MYLMMMM/car2025/README.md

# car2025
本项目是开发用于参赛的缩微电磁赛道智能车
参赛队伍：没电电磁队
