MYLMMMM/car2025/控制板/新建 文本文档.md

# 缩微电磁控制板使用说明

## 功能列表

### 板载部分

- 1.按钮，编码器
- 2.电源电压检测
- 3.电机驱动
- 4.电机电流检测
- 5.*起始点检测霍尔传感器*

### 接口

- 1.电机编码器
- 2.电磁传感器
- 3.电机
- 4.IMU
- 5.OLED
- 6.usb下载调试
- 7.蓝牙串口

## 详细说明

### 板载部分

#### 1.按钮、编码器

##### 引脚定义
| 名称 | 引脚 | 外设 |备注|
|---|---|---|---|
|PIN1|P2.1|GPIO|编码器按钮|
|PIN2|P2.0|GPIO| |
|PIN3|P4.0|GPIO| |
|PIN4|P5.7|GPIO| |
|RES|P4.7|GPIO| |
|ENC_A|P4.1|PWM定时器|寄存器配置，文档P887页|
|ENC_B|P4.5|GPIO|仅用于判断方向|

#### 2.电源电压检测
##### 引脚定义

| 名称 | 引脚 | 外设 |备注|
|---|---|---|---|
|VCC_ADC|P1.0|ADC||

##### 计算公式
电源电压 = ADC读取值*9

#### 3.电机驱动

##### 引脚定义

*待施工*

#### 4.电机电流检测

##### 引脚定义

*待施工*

### 接口部分

#### 1.电机编码器

##### 引脚定义
