MYLMMMM/car2025/控制板/BOM_主板第三版_PCB9_1_2025-06-06.xlsx

Quantity | Designator | Footprint | Value | Device | No.
1 | BUZ1 | BUZ-SMD_3P-L5.5-W5.0_5025 |  | 5025贴片蜂鸣器 | 1
1 | C1 | C0603 | 0.1uF | CAP_0402 | 2
3 | C2,C8,C9 | C0603 | 4.7uF | CAP_0402 | 3
1 | C4 | C0603 | 4.7nF | CAP_0402 | 4
1 | C5 | C0603 | 39pF | CAP_0402 | 5
1 | C10 | C0603 | 10pF | CAP_0402 | 6
16 | C13,C15,C16,C17,C18,C19,C30,C34,C35,C36,C37,C38,C39,C40,C41,C42 | C0603 | 100nF | CAP_0402,CAP_0603 | 7
4 | C20,C21,C31,C32 | C0603 | 1uF | CAP_0402 | 8
2 | C22,C23 | C0603 | 33uF | CAP_0603 | 9
1 | CN5 | CONN-TH_4P-P2.50_4PIN |  | ZX-XH2.54-4PZZ | 10
2 | CN8,CN9 | IDC-TH_6P-P2.54-H-R2-C3-S2.54 |  | 2.54-2*3P弯简牛 | 11
1 | CN10 | CONN-TH_3P-P2.54_2501S-3P |  | ZX-XH2.54-3PZZ | 12
1 | CN11 | HDR-TH_4P-P2.54-V-F |  | JTAG | 13
1 | CN12 | CONN-TH_XT30U-M |  | XT30U-M | 14
2 | CN13,CN14 | CONN-TH_2P-P2.50_HX25003-2A |  | ZX-XH2.54-2PZZ | 15
1 | D1 | SMA_L4.3-W2.6-LS5.1-RD |  | B340A | 16
2 | D3,D4 | SMA_L4.3-W2.6-LS5.2-RD |  | SS34_C8678 | 17
1 | D5 | SMA_L4.4-W2.6-LS5.0-RD |  | SMAJ5.0A | 18
3 | D6,D7,D8 | SMA_L4.3-W2.7-LS5.1-RD |  | SMAJ3.3A | 19
1 | H1 | HDR-TH_8P-P2.54-V-M |  | PZ254-1-08-Z-8.5 | 20
1 | H3 | HDR-TH_07P-P2.54-V-M |  | PZ254-1-07-Z-8.5 | 21
1 | H9 | HDR-TH_5P-P2.54-V-M |  | PZ254-1-05-Z-8.5 | 22
1 | L1 | IND-SMD_L4.9-W4.4_MAPM0420F | 4.7uH | HA42-4R7MT | 23
2 | LDO2,LDO3 | SOT-23-5_L3.0-W1.7-P0.95-LS2.8-BL |  | ME6211C33M5G-N | 24
4 | LED4,LED5,LED6,LED7 | LED_0603 |  | LED_0603-R | 25
2 | P1,P2 | HDR-TH_1P-P2.54-V-M |  | 2.54-1*1P针 | 26
7 | Q2,Q3,Q4,Q5,Q6,Q7,Q8 | SOT-23-3_L2.9-W1.3-P1.90-LS2.4-BR |  | AO3400A_C20917,MMBT3904(RANGE:100-300),MMBT3906_C18195368 | 27
17 | R1,R10,R11,R12,R13,R14,R15,R16,R17,R18,R19,R28,R29,R32,R33,R35,R40 | R0603 | 10K | Res_0402,Res_0603 | 28
1 | R2 | R0603 | 1.91K | Res_0402 | 29
1 | R3 | R0603 | 49.9k | Res_0402 | 30
2 | R4,R5 | R0603 | 5.1k | Res_0402 | 31
1 | R23 | R0603 | 8K | Res_0603 | 32
1 | R24 | R0603 | 1K | Res_0603 | 33
2 | R25,R26 | R0603 | 22 | Res_0603 | 34
1 | R27 | R0603 | 300R | Res_0603 | 35
2 | R30,R31 | R0603 | 3.3k | Res_0603 | 36
1 | R34 | R0603 | 10 | Res_0603 | 37
2 | R36,R37 | R0603 | 0k | Res_0603 | 38
2 | R38,R39 | R0603 | 50 | Res_0603 | 39
1 | SW1 | SW-TH_EC11K0925416 |  | EC11K0925416 | 40
1 | SW3 | SW-TH_2P-L4.1-W9.6-P2.54-LS7.62 |  | TA-01 | 41
1 | U1 | LQFP-48_L7.0-W7.0-P0.50-LS9.0-BL_1 |  | AI8051U-34K64-QFP48 | 42
2 | U2,U12 | SOIC-8_L4.9-W3.9-P1.27-LS6.0-BL |  | TLV9002IDR,TPS54331DG4 | 43
3 | U4,U5,U7 | SW-TH_4P-L6.0-W6.0-P4.50-LS6.5 |  | TC-6610 6*6*5 160g | 44
1 | U13 | CONN-TH_7P-P1.25_XUNPU_WAFER-MX1.25-7PZZ |  | WAFER-MX1.25-7PZZ | 45
2 | U14,U15 | SOT-23-5_L2.9-W1.6-P0.95-LS2.8-BR |  | INA180B1IDBVR | 46
1 | USB1 | USB-C-SMD_TYPE-C16PIN |  | TYPE-C16PIN | 47
