MYLMMMM/car2025/3d设计文件/3d打印文件/传感器固定架子20度加长.SLDPRT

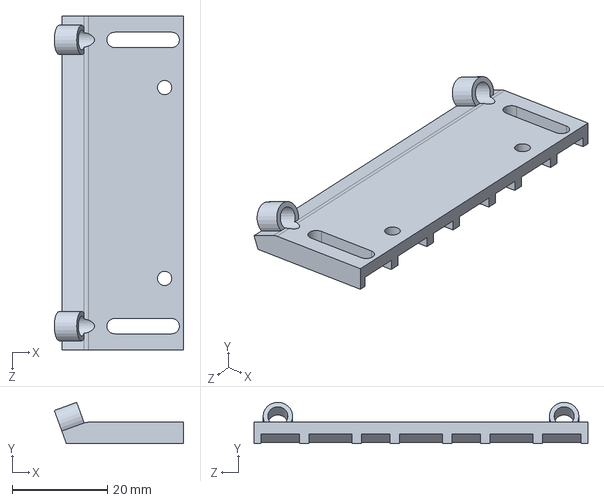
[picture p1: CAD file, 2025-07-23]
3d设计文件/3d打印文件/传感器固定架子20度加长.SLDPRT
27.1 x 8.67 x 70.0 mm
