MYLMMMM/car2025/3d设计文件/3d打印文件/新建文件夹/后保险杠.3MF

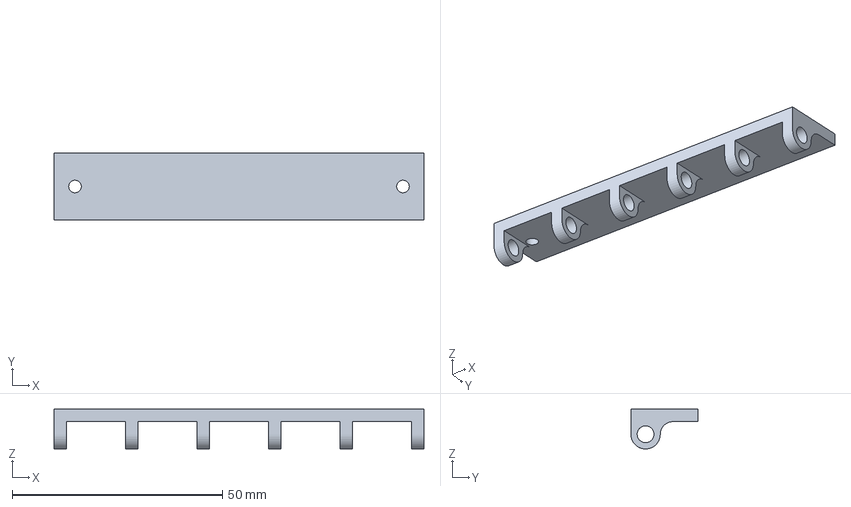
[picture p2: CAD file, 2025-07-23]
3d设计文件/3d打印文件/新建文件夹/后保险杠.3MF
88.0 x 16.0 x 9.50 mm
