MYLMMMM/car2025/3d设计文件/new车模文件/180电机.SLDPRT

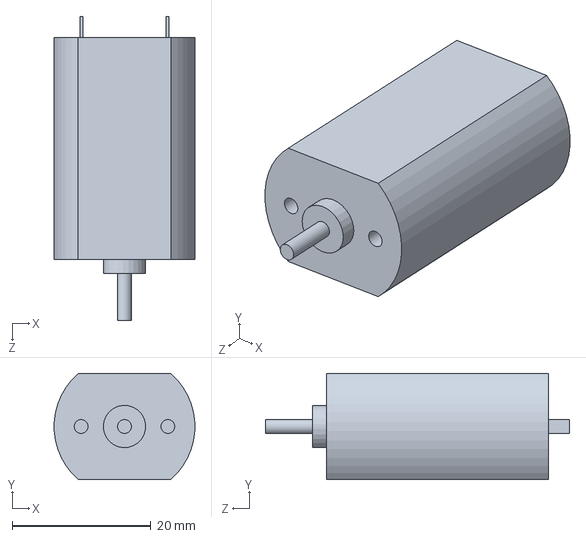
[picture p3: CAD file, 2025-07-23]
3d设计文件/new车模文件/180电机.SLDPRT
20.3 x 15.3 x 43.8 mm
