MYLMMMM/car2025/3d设计文件/测试3d文件/尺寸测试.SLDPRT

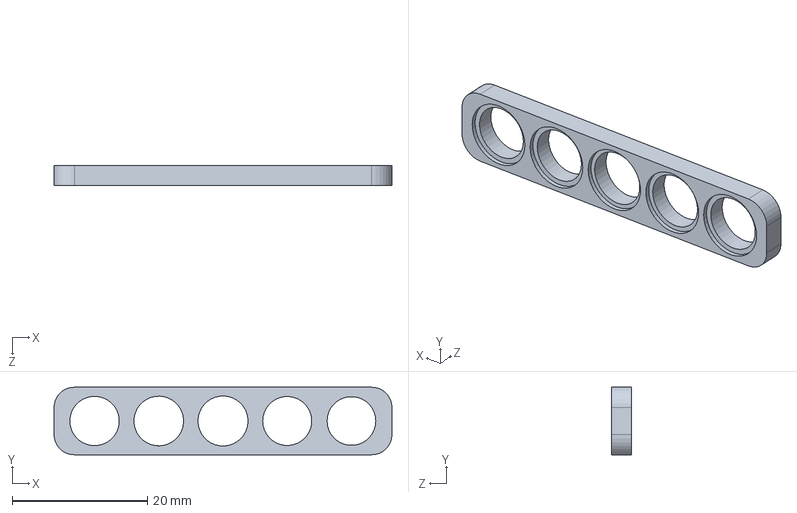
[picture p4: CAD file, 2025-06-23]
3d设计文件/测试3d文件/尺寸测试.SLDPRT
50.0 x 10.0 x 3.00 mm
