MYLMMMM/car2025/3d设计文件/车模3D文件/挡板基体-v2.0.SLDPRT

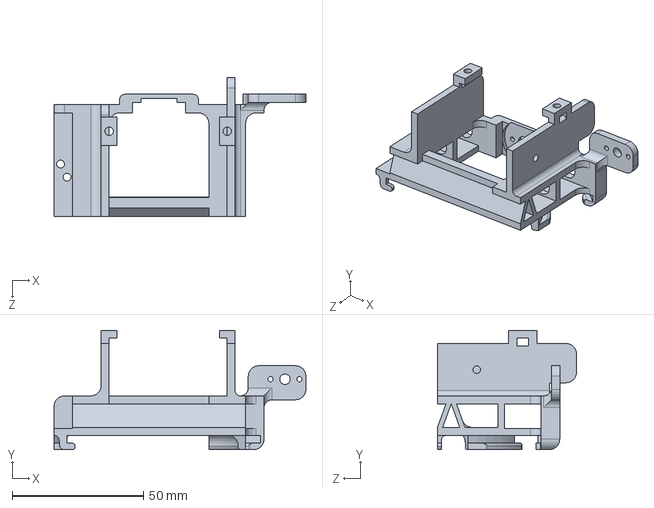
[picture p5: CAD file, 2025-06-23]
3d设计文件/车模3D文件/挡板基体-v2.0.SLDPRT
96.0 x 45.5 x 53.0 mm
