MYLMMMM/car2025/3d设计文件/3d打印文件/新建文件夹/线圈托片.3MF

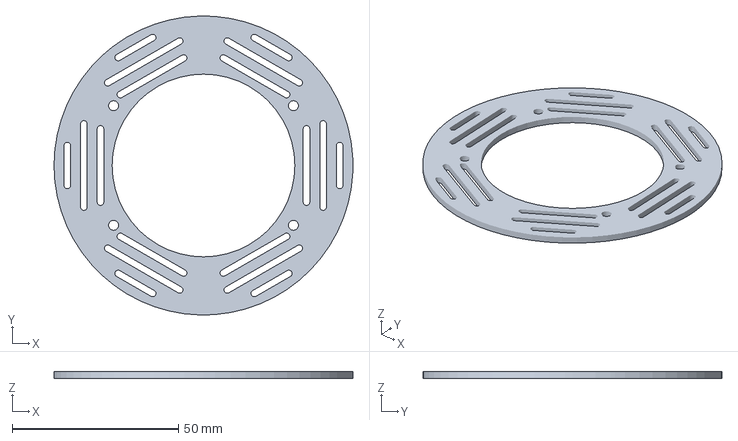
[picture p6: CAD file, 2025-07-23]
3d设计文件/3d打印文件/新建文件夹/线圈托片.3MF
90.0 x 90.0 x 2.00 mm
