MYLMMMM/car2025/3d设计文件/车模3D文件/轮胎.SLDPRT

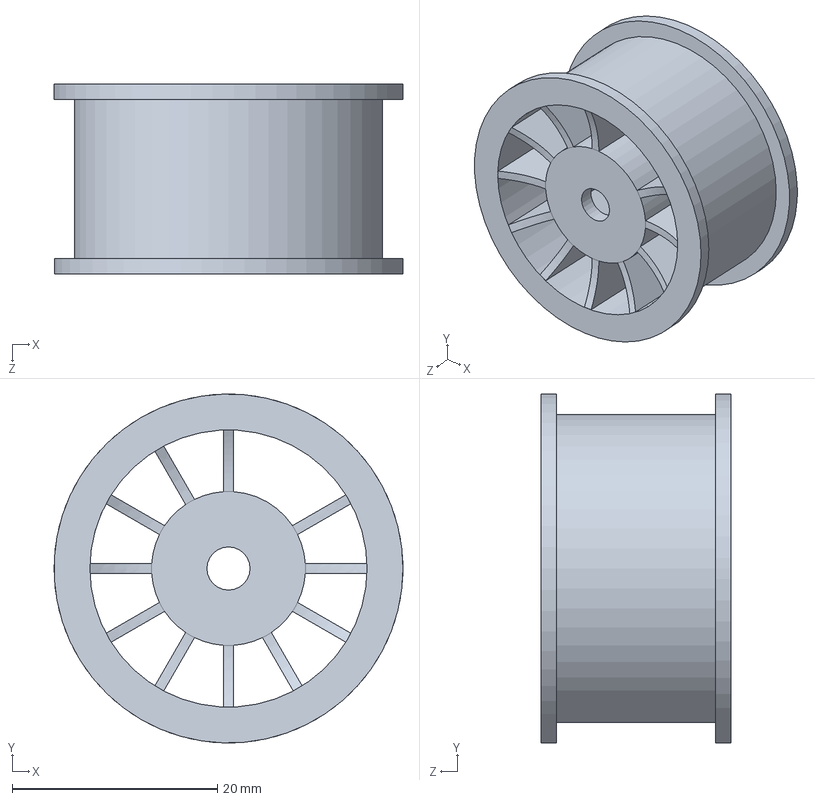
[picture p7: CAD file, 2025-06-23]
3d设计文件/车模3D文件/轮胎.SLDPRT
34.0 x 34.0 x 18.5 mm
