MYLMMMM/car2025/3d设计文件/3d打印文件/前保险杠30度.3MF

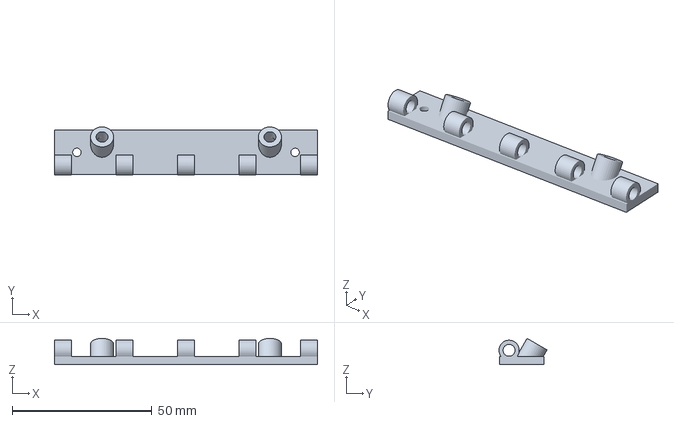
[picture p8: CAD file, 2025-07-23]
3d设计文件/3d打印文件/前保险杠30度.3MF
94.0 x 17.2 x 9.40 mm
