MYLMMMM/car2025/3d设计文件/3d打印文件/新建文件夹/侧板另一边.3MF

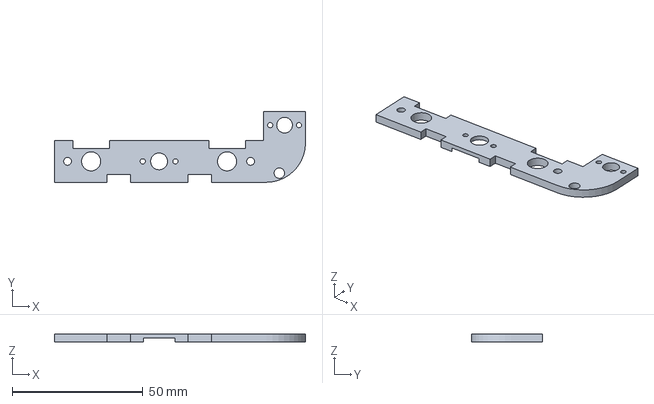
[picture p9: CAD file, 2025-07-23]
3d设计文件/3d打印文件/新建文件夹/侧板另一边.3MF
96.0 x 27.0 x 3.00 mm
