MYLMMMM/car2025/3d设计文件/参考文件/四轮完整版 - 车板.3mf

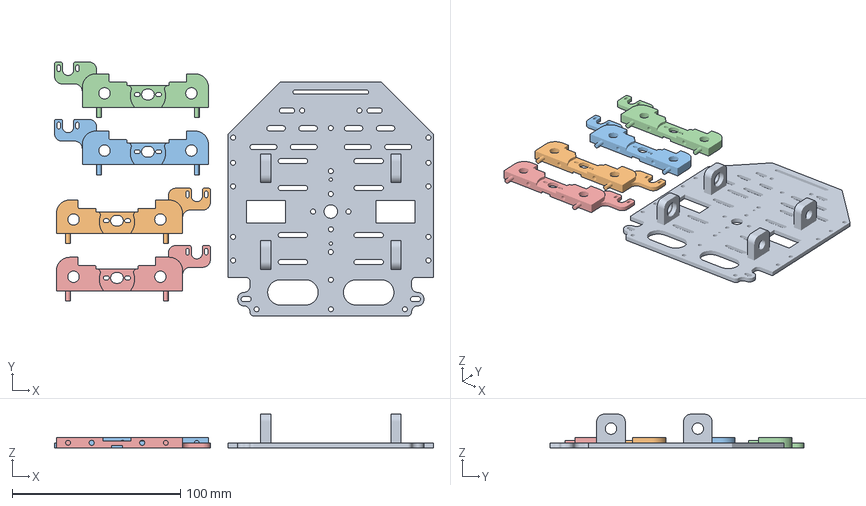
[picture p10: CAD file, 2025-06-23]
3d设计文件/参考文件/四轮完整版 - 车板.3mf
225.1 x 150.8 x 20.0 mm
四轮完整版 - 车板.STL
四轮完整版 - 右挡板.STL x 2
四轮完整版 - 左挡板.STL x 2
