MYLMMMM/car2025/3d设计文件/3d打印文件/传感器固定架子20度.3MF

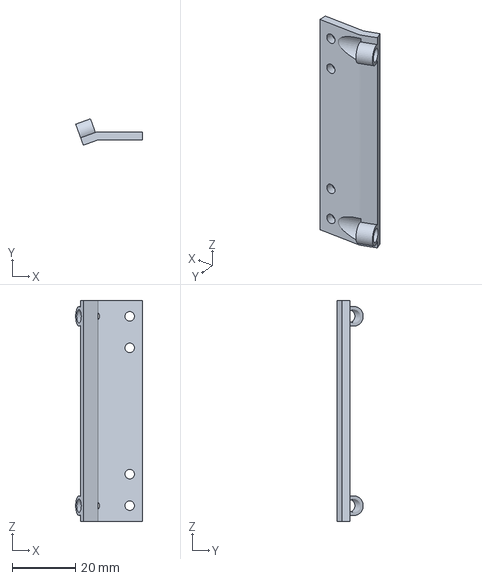
[picture p11: CAD file, 2025-07-23]
3d设计文件/3d打印文件/传感器固定架子20度.3MF
21.1 x 8.38 x 70.0 mm
