MYLMMMM/car2025/3d设计文件/3d打印文件/新建文件夹/传感器固定架子.3mf

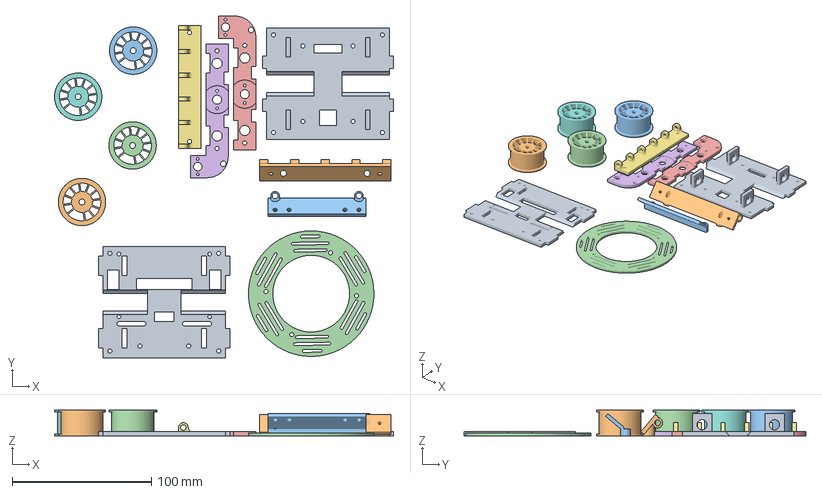
[picture p12: CAD file, 2025-07-23]
3d设计文件/3d打印文件/新建文件夹/传感器固定架子.3mf
243.0 x 245.1 x 18.5 mm
底板
前保险杠
传感器固定架子
线圈托片
侧板
侧板另一边
后保险杠
轮胎 x 4
顶板
