MYLMMMM/car2025/3d设计文件/车模3D文件/传感器支架.SLDPRT

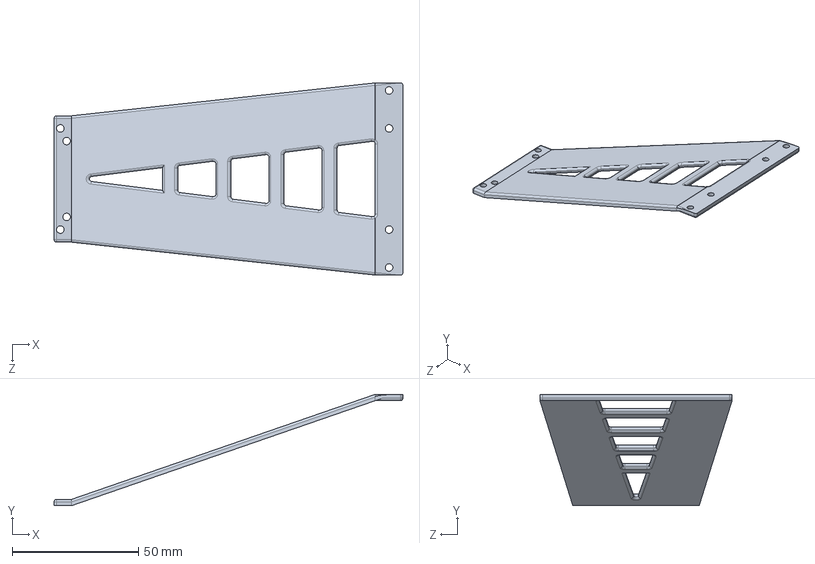
[picture p13: CAD file, 2025-06-23]
3d设计文件/车模3D文件/传感器支架.SLDPRT
138.0 x 44.0 x 76.0 mm
