MYLMMMM/car2025/3d设计文件/3d打印文件/新建文件夹/顶板.3MF

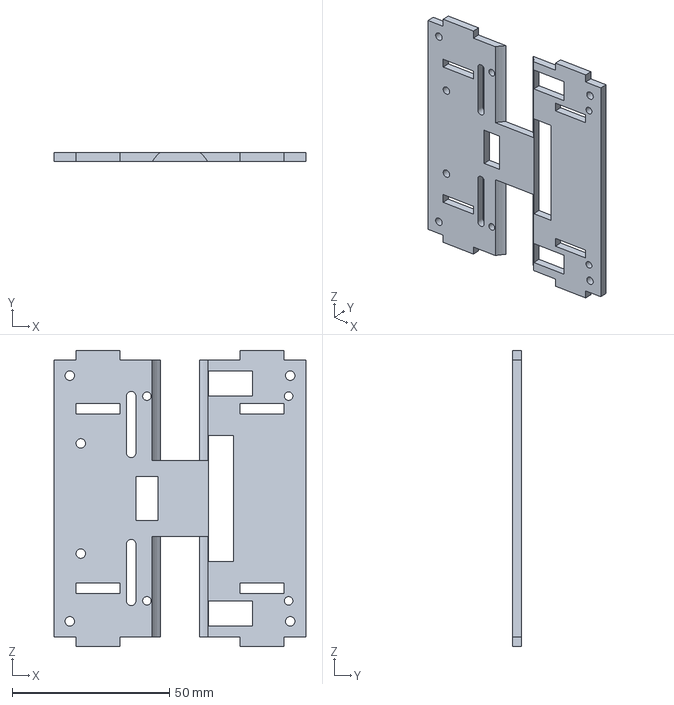
[picture p14: CAD file, 2025-07-23]
3d设计文件/3d打印文件/新建文件夹/顶板.3MF
80.0 x 3.00 x 94.0 mm
