MYLMMMM/car2025/3d设计文件/3d打印文件/轮胎加宽.3MF

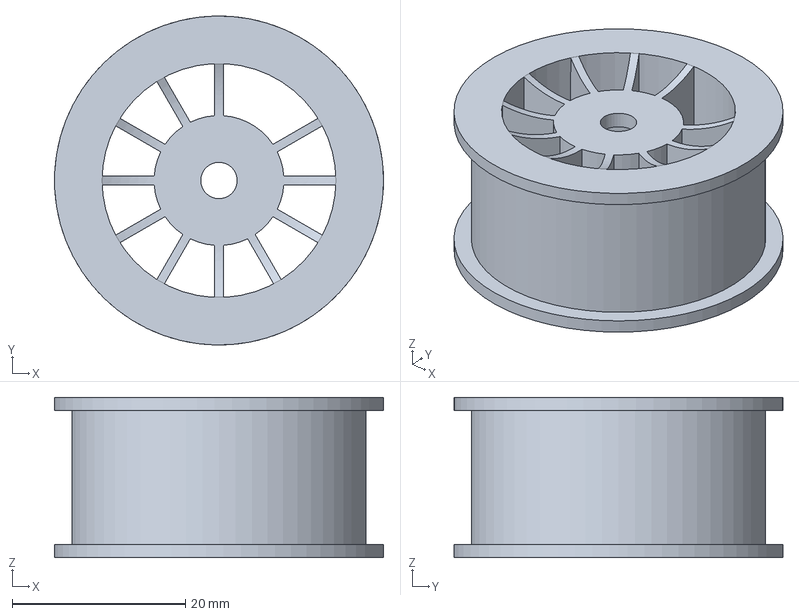
[picture p15: CAD file, 2025-07-23]
3d设计文件/3d打印文件/轮胎加宽.3MF
38.0 x 38.0 x 18.5 mm
