MYLMMMM/car2025/3d设计文件/3d打印文件/传感器固定架子30度.3MF

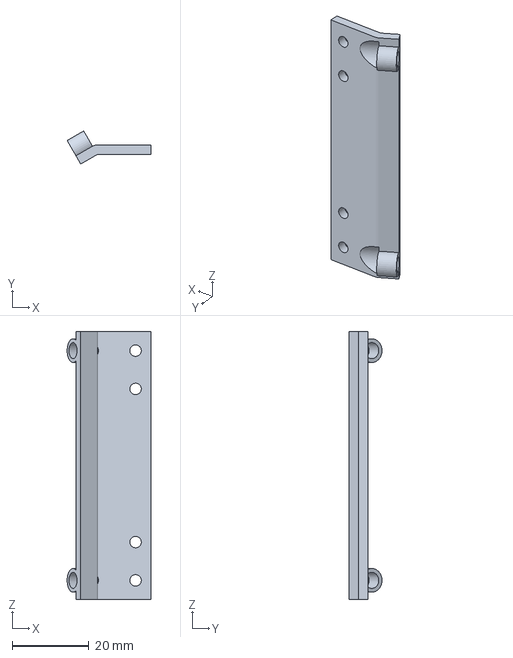
[picture p16: CAD file, 2025-07-23]
3d设计文件/3d打印文件/传感器固定架子30度.3MF
21.9 x 8.65 x 70.0 mm
