MYLMMMM/car2025/3d设计文件/3d打印文件/塑料光头胎.3MF

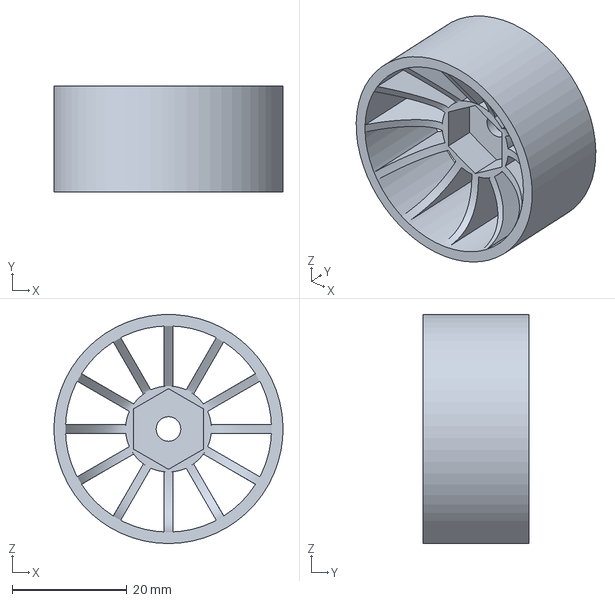
[picture p17: CAD file, 2025-07-23]
3d设计文件/3d打印文件/塑料光头胎.3MF
40.0 x 18.5 x 40.0 mm
