MYLMMMM/car2025/3d设计文件/3d打印文件/新建文件夹/六角联轴器.3MF

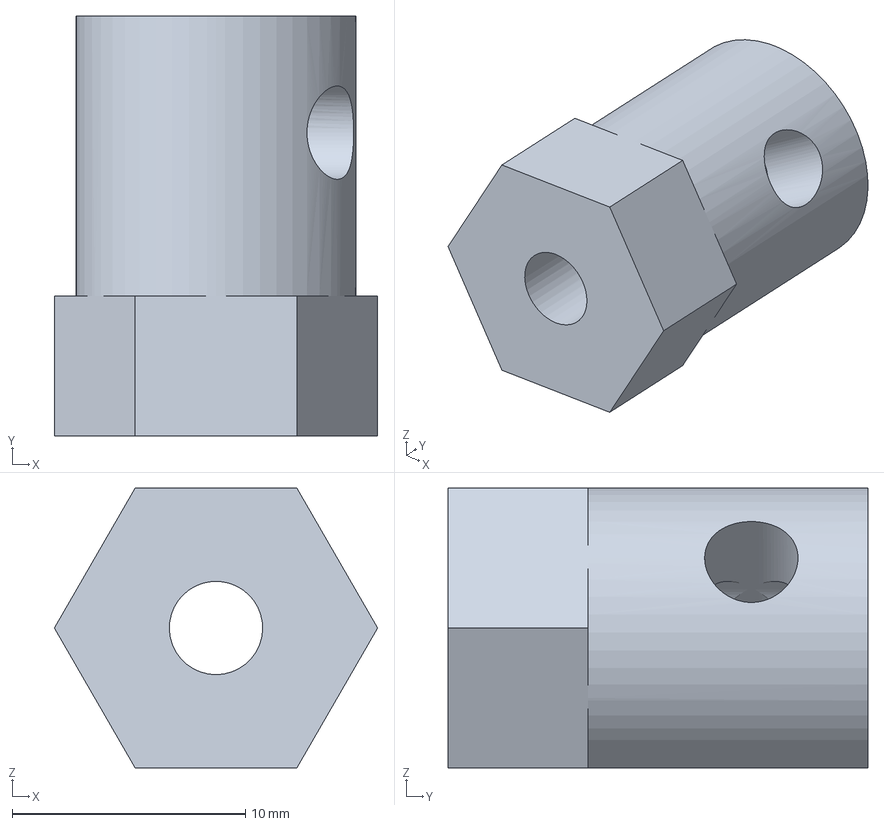
[picture p18: CAD file, 2025-07-23]
3d设计文件/3d打印文件/新建文件夹/六角联轴器.3MF
13.9 x 18.0 x 12.0 mm
