MYLMMMM/car2025/3d设计文件/3d打印文件/前保险杠20度.3mf

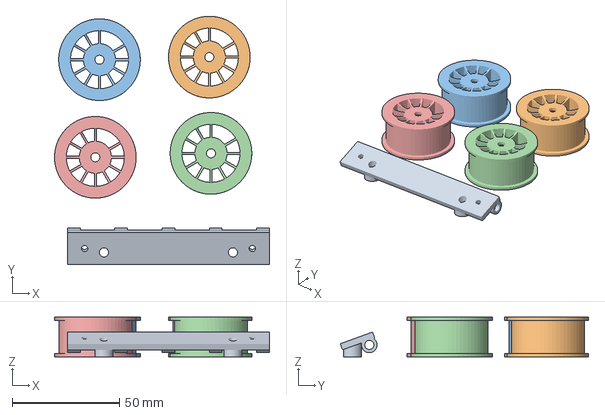
[picture p19: CAD file, 2025-07-23]
3d设计文件/3d打印文件/前保险杠20度.3mf
100.0 x 115.6 x 18.5 mm
前保险杠20度
轮胎加宽 x 4
