MYLMMMM/car2025/3d设计文件/3d打印文件/新建文件夹/打印文件.3mf

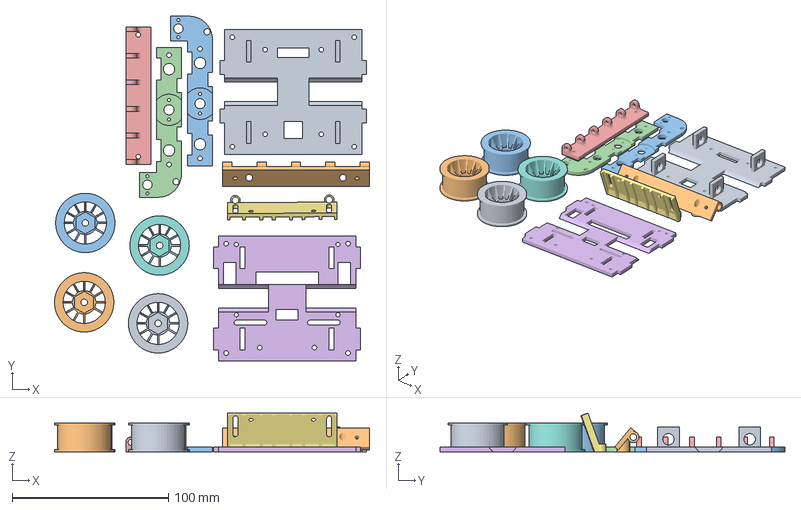
[picture p20: CAD file, 2025-07-23]
3d设计文件/3d打印文件/新建文件夹/打印文件.3mf
201.5 x 220.6 x 24.6 mm
底板
前保险杠
侧板
侧板另一边
后保险杠
顶板
传感器固定架子20度加长
轮胎加宽 x 4
