MYLMMMM/car2025/3d设计文件/3d打印文件/新建文件夹/前保险杠.3MF

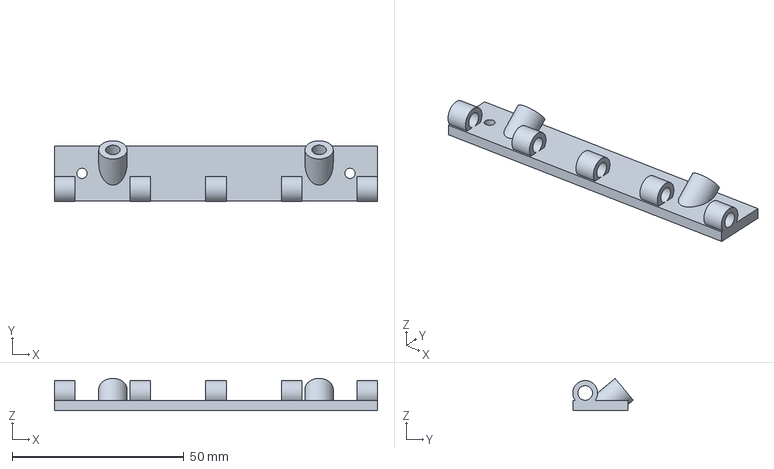
[picture p21: CAD file, 2025-07-23]
3d设计文件/3d打印文件/新建文件夹/前保险杠.3MF
94.0 x 17.6 x 9.38 mm
