MYLMMMM/car2025/3d设计文件/3d打印文件/尺寸测v2.0.3mf

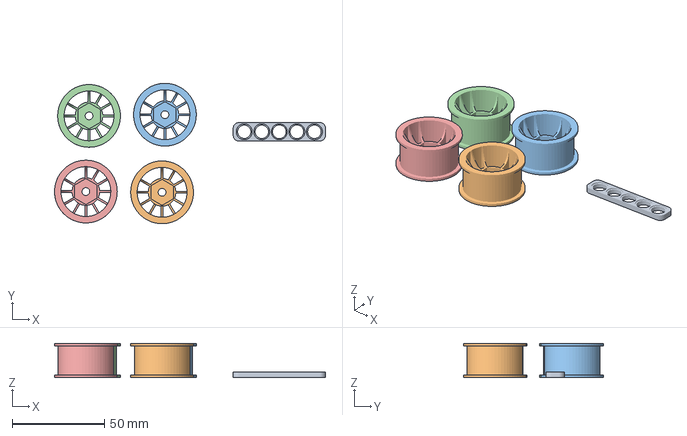
[picture p22: CAD file, 2025-06-23]
3d设计文件/3d打印文件/尺寸测v2.0.3mf
146.8 x 76.0 x 18.5 mm
尺寸测v2.0
轮胎 x 4
