MYLMMMM/car2025/3d设计文件/3d打印文件/新建文件夹/底板.3MF

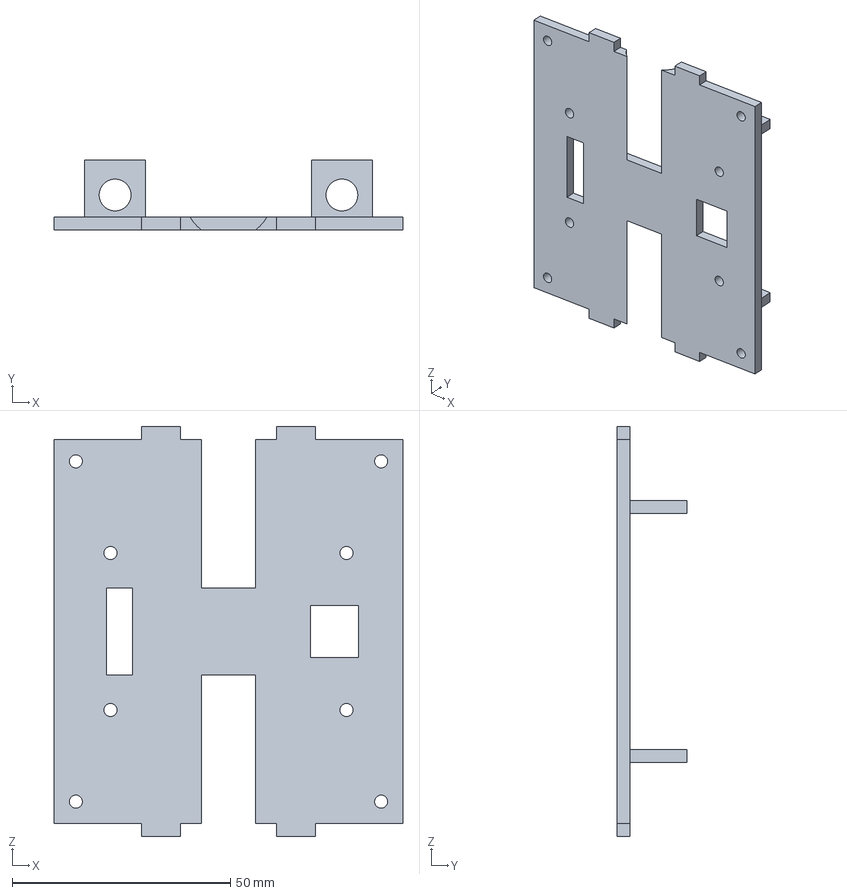
[picture p23: CAD file, 2025-07-23]
3d设计文件/3d打印文件/新建文件夹/底板.3MF
80.0 x 16.0 x 94.0 mm
