MYLMMMM/car2025/3d设计文件/3d打印文件/挡板基体.3mf

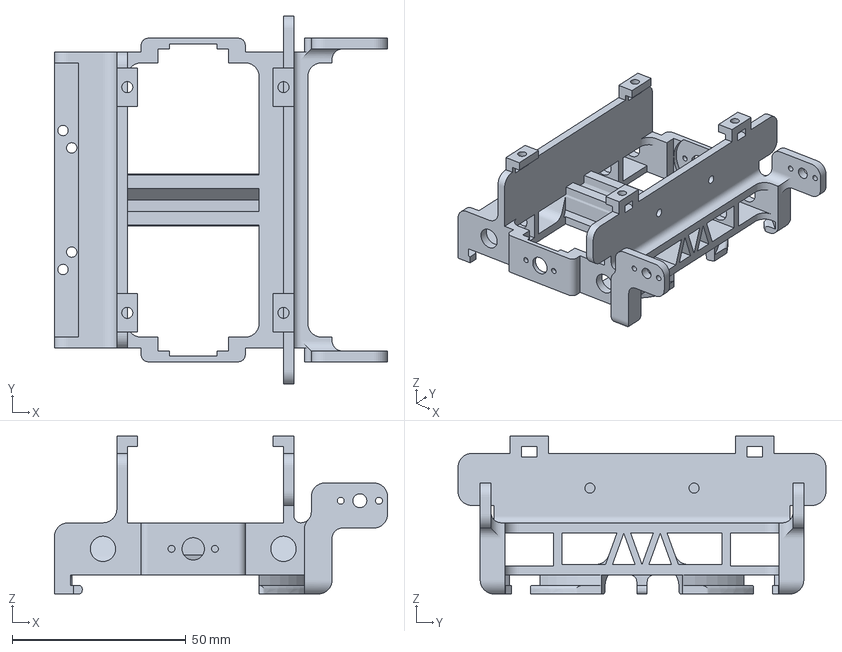
[picture p24: CAD file, 2025-06-23]
3d设计文件/3d打印文件/挡板基体.3mf
96.0 x 106.0 x 45.5 mm
