MYLMMMM/car2025/(list of files, cad)

Other CAD files:
3d设计文件/参考文件/四轮完整版 - 车板.gcode.3mf
3d设计文件/3d打印文件/打印文件.gcode.3mf
3d设计文件/参考文件/四轮完整版 - 右挡板.sldprt
3d设计文件/车模3D文件/PCB车板.SLDPRT
3d设计文件/参考文件/四轮完整版 - 左挡板.sldprt
3d设计文件/车模3D文件/零件1.SLDPRT
3d设计文件/3d打印文件/新建文件夹/侧板.3MF
3d设计文件/3d打印文件/前保险杠20度.gcode.3mf
3d设计文件/3d打印文件/新建文件夹/轮胎.3MF
3d设计文件/3d打印文件/轮胎v1.0.3MF
3d设计文件/3d打印文件/尺寸测试.3mf
3d设计文件/3d打印文件/传感器支架.3MF
3d设计文件/3d打印文件/传感器固定架子20度加长.3MF
3d设计文件/参考文件/四轮完整版 - 右挡板.STL
3d设计文件/参考文件/四轮完整版 - 左挡板.STL
3d设计文件/参考文件/四轮完整版 - 车板.STL
3d设计文件/车模3D文件/挡板基体.SLDPRT
