MYLMMMM/car2025/相关参考文档/无线充电接收端V2.0原理图.pdf

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
WirelessChargingReceive | 猫肆管
| V2.0.1.0
2023/5/4 | 17:17:07
Title: | Author:

Date:

Revision:
Size: A4 | Time: | Sheet: | of:

### Subtitle: Revision

V1.0~V1.2 | 试验版本，单纯接收
版本号 | 修订日期 | 修订记录

2021-11-4

在此文件中，仅以版本号前两位(发行版)，划分版本之间的区别。

版权所有，保留一切权利。
本公司致力于产品的不断改善和功能升级，内容如有改动，恕不另行通知。
V1.3 | 2022-2-28 | 增加施密特触发器进行保护
V2.0.0.0 | 2023-4-7 | 更换二极管，加散热
V2.0.1.0 | 2023-4-19 | 更改板型 SEEKFREE

## 谐振部分

## 整流部分

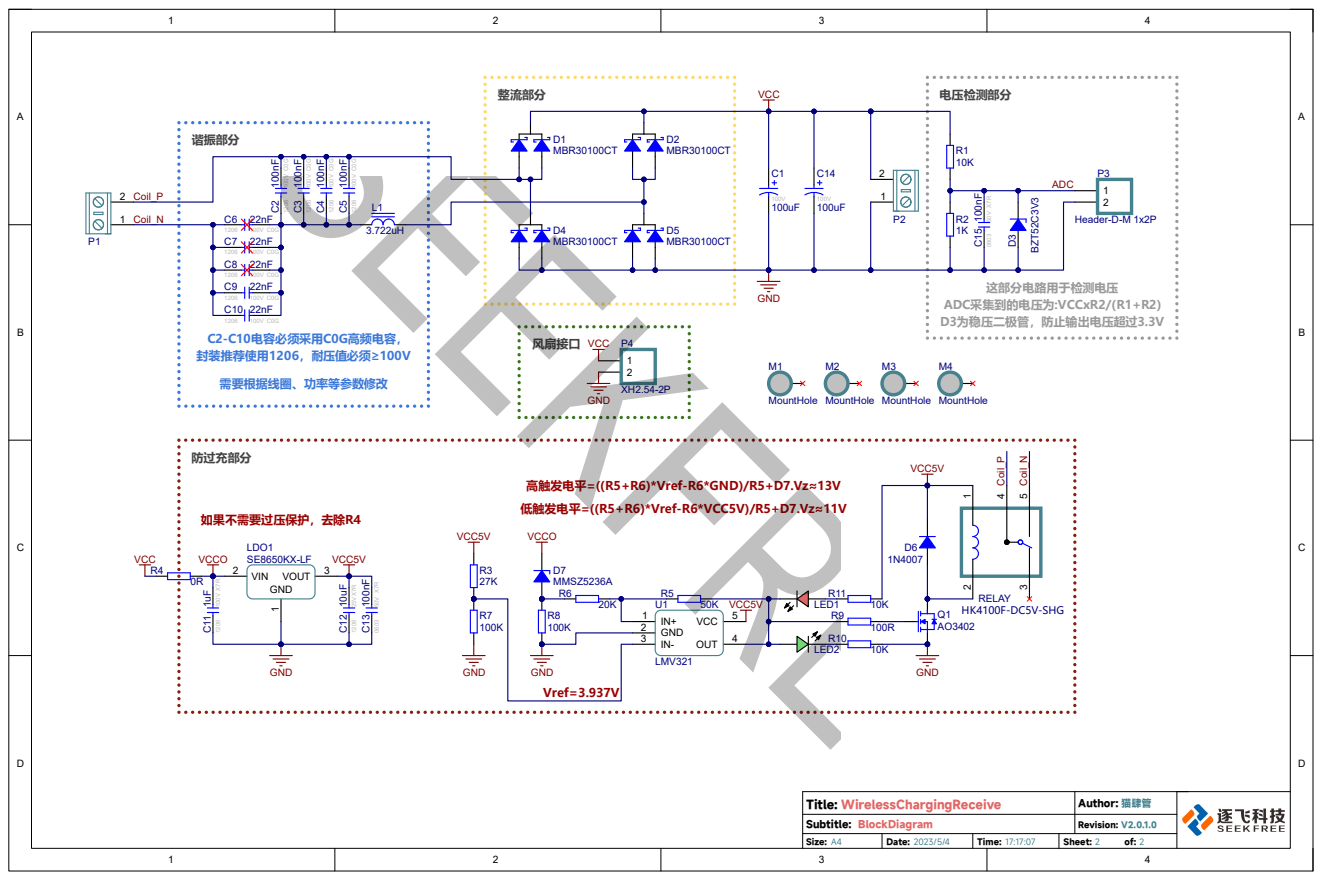
[picture p25: page 2]

高触发电平=((R5+R6)*Vref-R6*GND)/R5+D7.Vz≈13V
低触发电平=((R5+R6)*Vref-R6*VCC5V)/R5+D7.Vz≈11V
