MYLMMMM/car2025/(list of files, drawings)

Other design files:
EDA/car1.eprj
