MYLMMMM/car2025/(commit log)

2025-06-23 Create 挡板基体.SLDPRT
    第二版的车体结构
    [挡板基体.SLDPRT]
2025-06-23 尝试一下kraken
    确实还不错
2025-06-23 创建了redeme文档
2025-06-23 创建了仓库，移入了之前的文件
    [BOM_主板第三版_PCB9_1_2025-06-06.xlsx, PCB车板.SLDPRT, PickAndPlace_PCB9_1_2025-06-06.xlsx, Portmap.xlsx, 传感器支架.3MF, 传感器支架.SLDPRT, 四轮完整版 - 右挡板.STL, 四轮完整版 - 右挡板.sldprt]
2025-06-23 添加了主控板的工程文件
    [car1.eprj]
2025-06-23 添加了用于记录当前问题的md文件
